LMSBAND/lms-rig/surface/enclosure/renders/corners.png

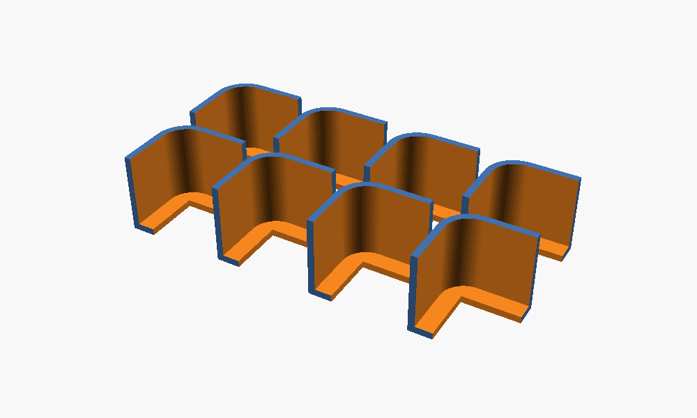
surface/enclosure/renders/corners.png
