LMSBAND/lms-rig/surface/enclosure/renders/faceplate_back.png

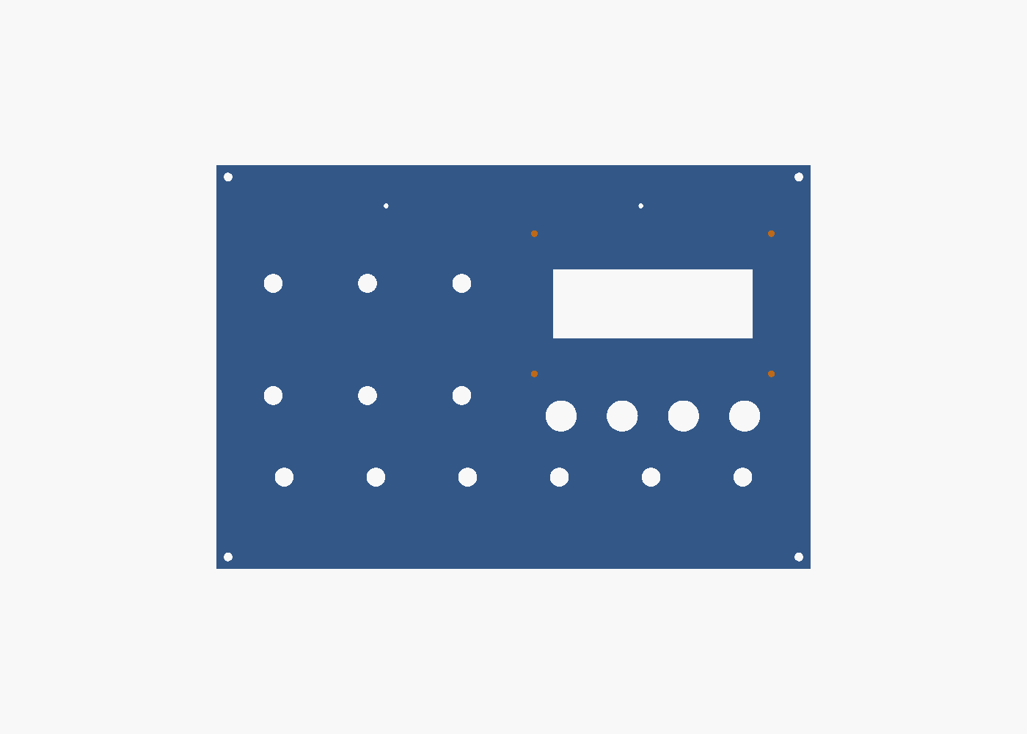
surface/enclosure/renders/faceplate_back.png
