LMSBAND/lms-rig/surface/enclosure/renders/handle.png

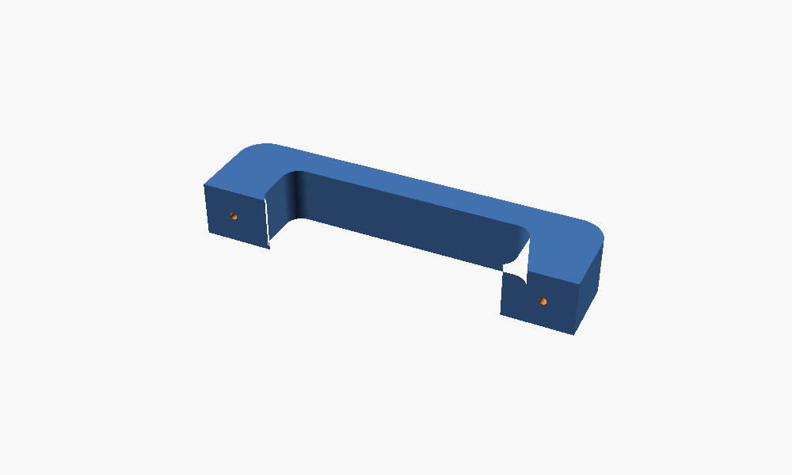
surface/enclosure/renders/handle.png
