LMSBAND/lms-rig/surface/enclosure/renders/head_front.png

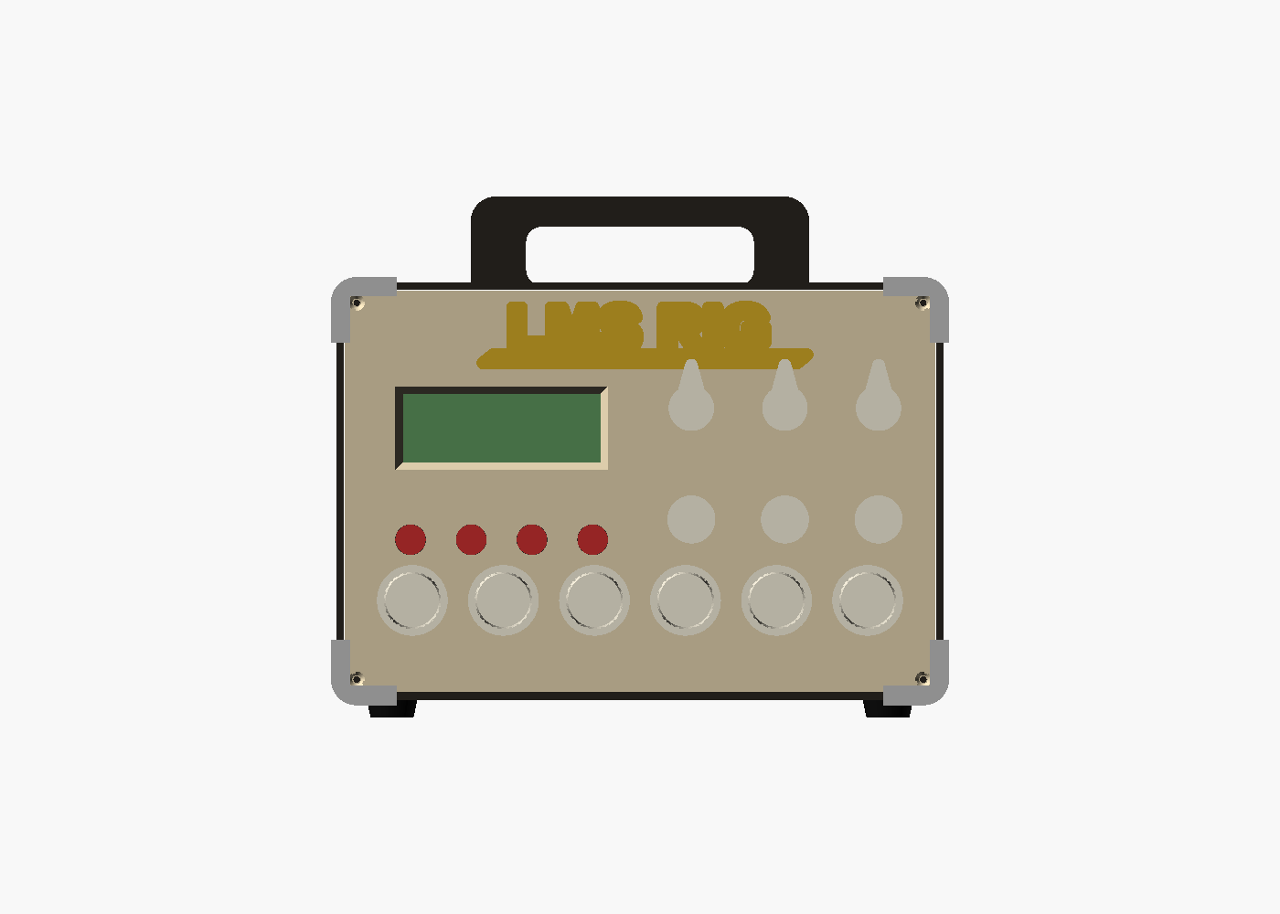
surface/enclosure/renders/head_front.png
