LMSBAND/lms-rig/surface/enclosure/renders/inserts.png

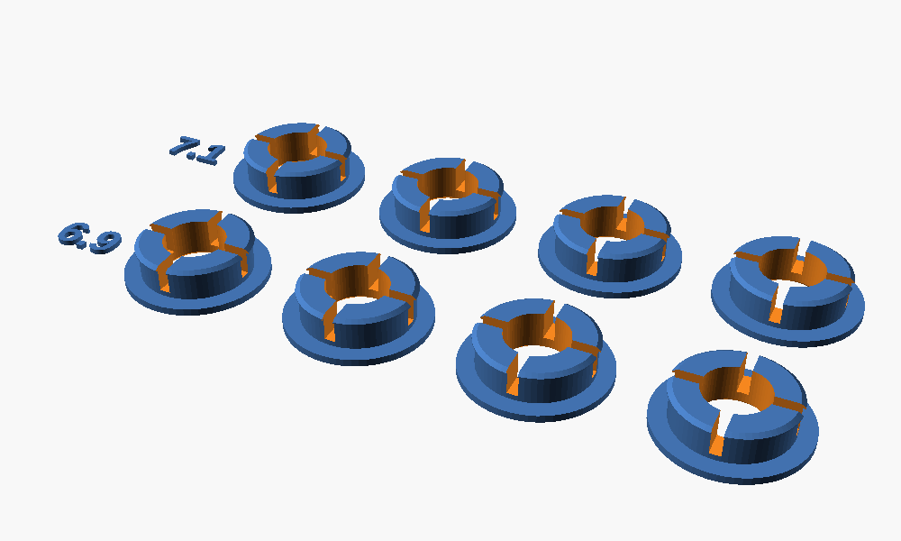
surface/enclosure/renders/inserts.png
