LMSBAND/lms-rig/surface/enclosure/stl/head_back.stl

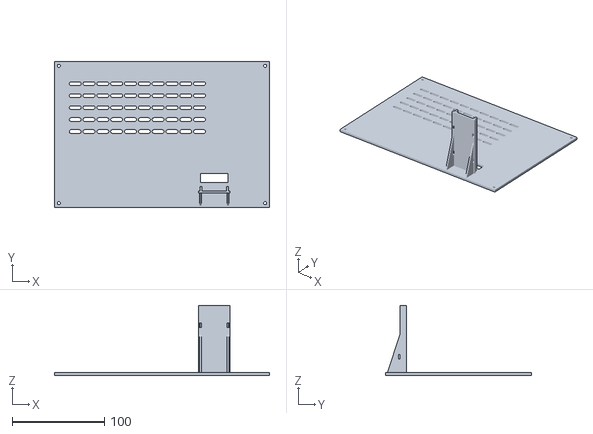
[picture p6: CAD file, 2026-10-26]
surface/enclosure/stl/head_back.stl
233.4 x 158.4 x 76.0
