LMSBAND/lms-rig/surface/enclosure/stl/head_badge.stl

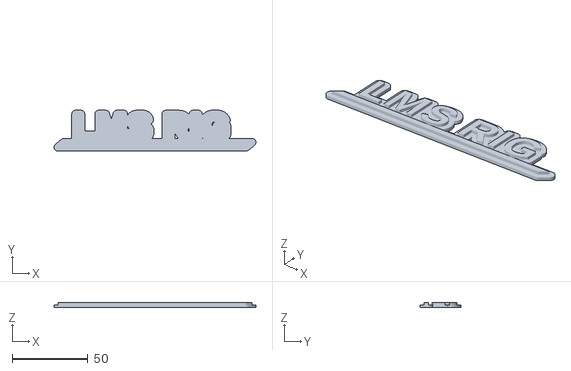
[picture p7: CAD file, 2026-10-26]
surface/enclosure/stl/head_badge.stl
133.2 x 27.2 x 3.40
