LMSBAND/lms-rig/surface/enclosure/stl/head_knobs.stl

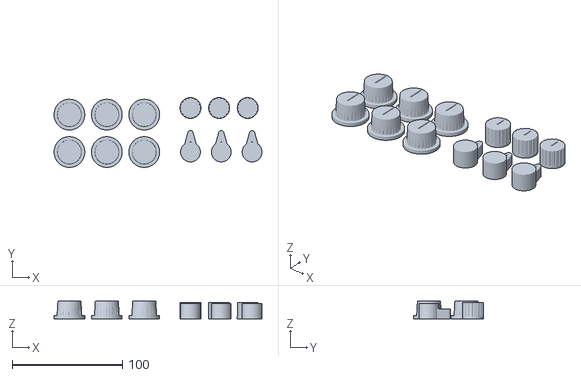
[picture p8: CAD file, 2026-10-26]
surface/enclosure/stl/head_knobs.stl
189.0 x 63.5 x 16.0
