LMSBAND/lms-rig/surface/enclosure/stl/head_inserts.stl

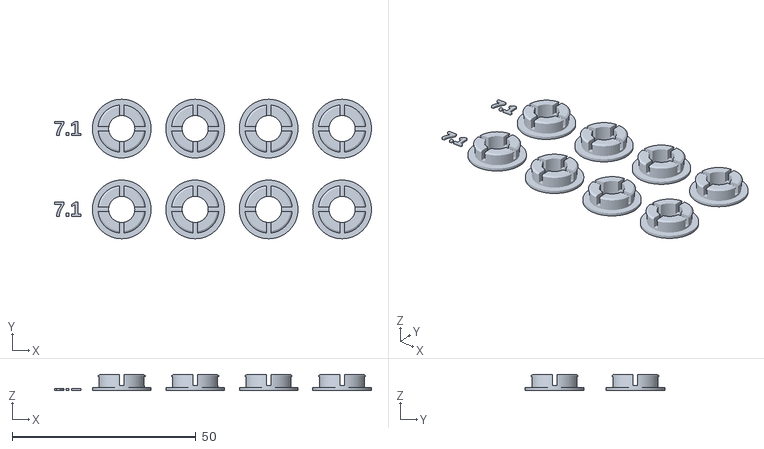
[picture p9: CAD file, 2026-10-26]
surface/enclosure/stl/head_inserts.stl
86.3 x 38.0 x 4.40
