LMSBAND/lms-rig/surface/enclosure/stl/head_sleeve.stl

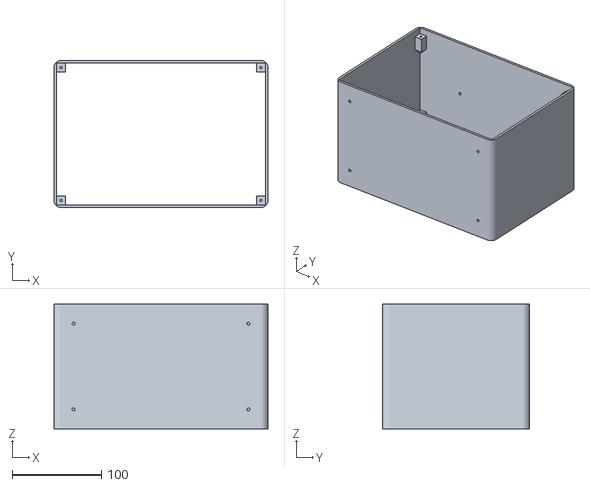
[picture p10: CAD file, 2026-10-26]
surface/enclosure/stl/head_sleeve.stl
240.0 x 165.0 x 140.0
