LMSBAND/lms-rig/surface/enclosure/stl/head_handle.stl

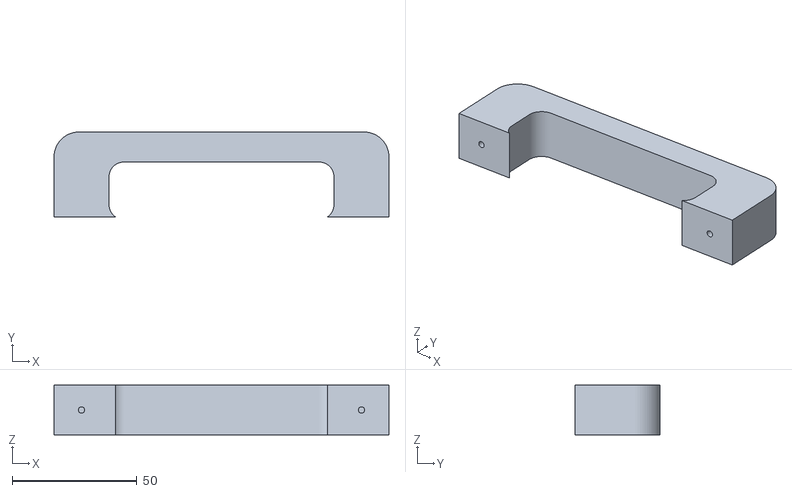
[picture p11: CAD file, 2026-10-26]
surface/enclosure/stl/head_handle.stl
134.0 x 34.0 x 20.0
