LMSBAND/lms-rig/surface/enclosure/stl/head_faceplate.3mf

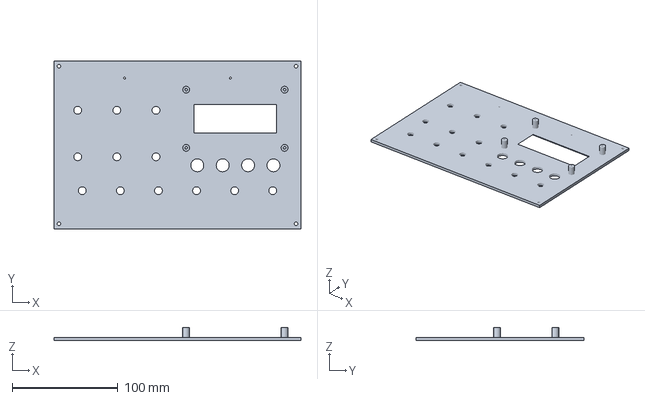
[picture p12: CAD file, 2026-10-26]
surface/enclosure/stl/head_faceplate.3mf
233.4 x 158.4 x 12.5 mm
