LMSBAND/lms-rig/surface/enclosure/stl/head_corners.stl

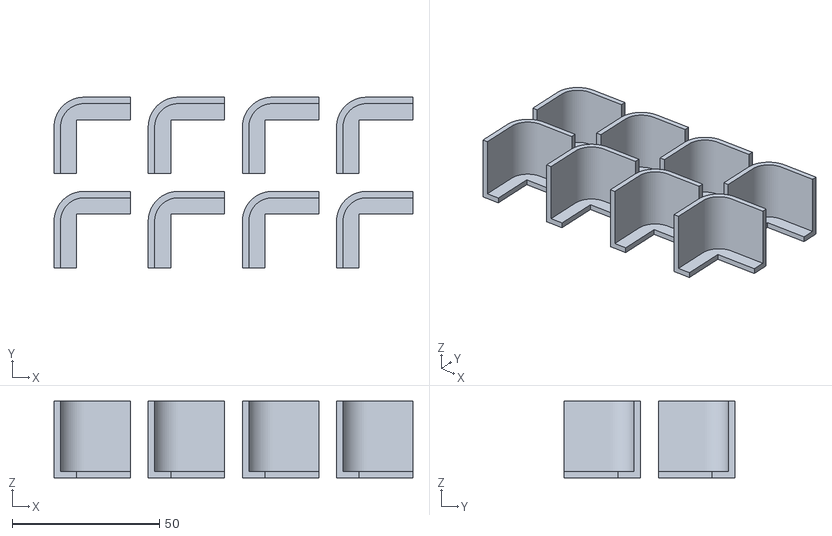
[picture p13: CAD file, 2026-10-26]
surface/enclosure/stl/head_corners.stl
122.0 x 58.0 x 26.0
