LMSBAND/lms-rig/surface/enclosure/stl/head_feet.stl

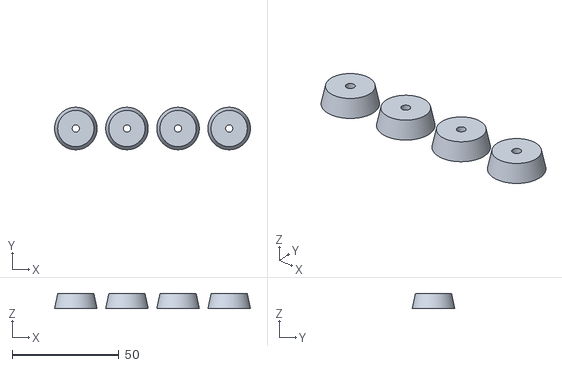
[picture p14: CAD file, 2026-10-26]
surface/enclosure/stl/head_feet.stl
92.0 x 20.0 x 7.00
