LMSBAND/lms-rig/(list of files, cad)

Other CAD files:
surface/enclosure/stl/head_faceplate.stl
