LMSBAND/lms-rig/surface/enclosure/renders/head_assembly.png

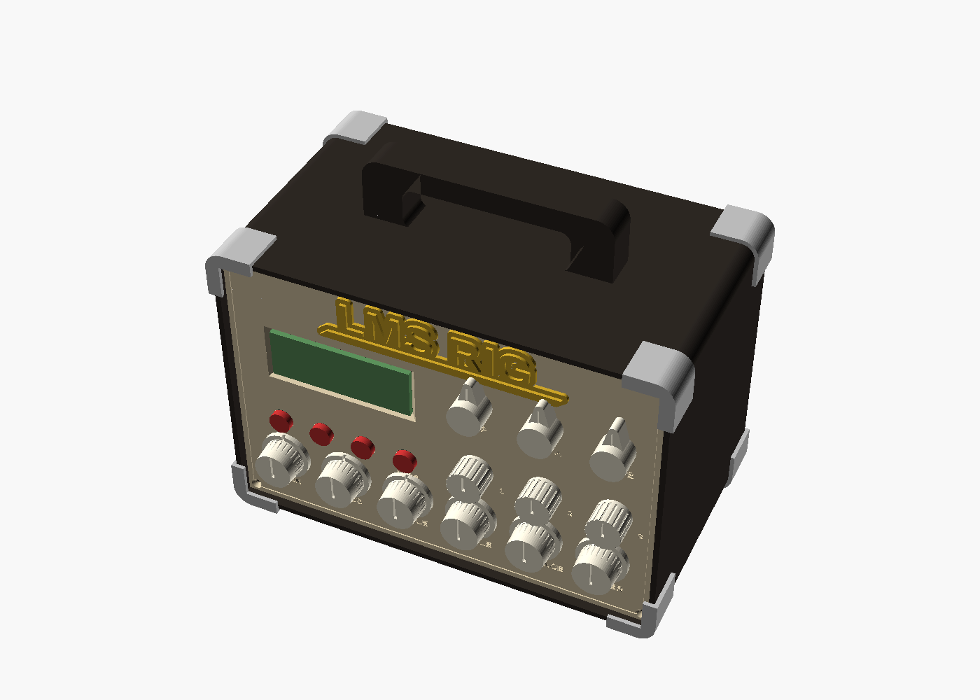
surface/enclosure/renders/head_assembly.png
