LMSBAND/lms-rig/surface/enclosure/renders/sleeve_print.png

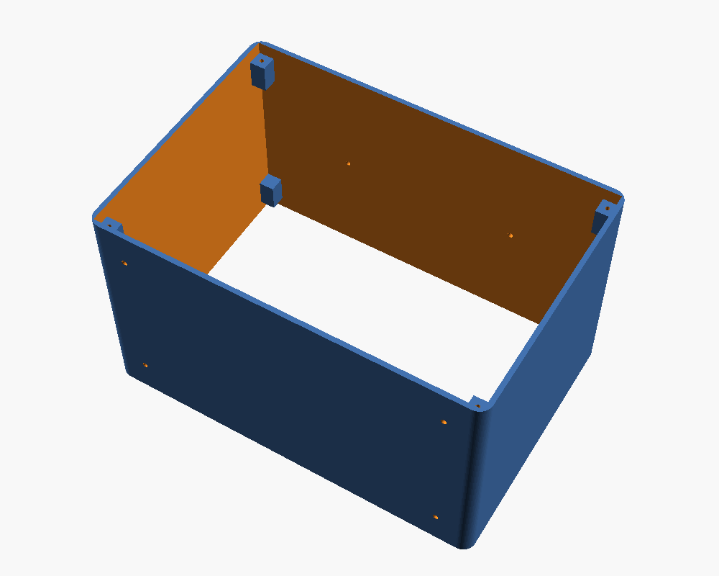
surface/enclosure/renders/sleeve_print.png
