LMSBAND/lms-rig/(commit log)

2026-10-17 LMS Rig: standalone pedalboard -> amp head -> cab host
    - ysfx-based JUCE host, three sections, amps switchable, cab state persists across heads
    - JSFX bundled into the binary, extracted to app data on launch
    - CI builds Linux, macOS universal, Windows
2026-10-17 Sync pedal circuit fixes; installer replaces running binary
    - jsfx/: RAT, TS, BD-2, ODB-3, spring, stepper, delay/flanger fixes from LMS
    - install.sh: unlink old binary before copy
2026-10-17 Native pedalboard and amp panels; hide inactive pedals
    - Pedals as stompbox cards with footswitches, comp strips, signal flow
    - Amp head as a faceplate of sections built from its sliders
    - Hide inactive toggle and Classic view toggle, saved with the rig
    - Keep the JSFX header and tuner strip above the native board
    - Amp picker follows the loaded head after a state load
2026-10-18 Fix output clipping, first-pick dropdowns; add impedance match light
    - Sync amps: true-peak limiter replaces the post-cab hard clamp
    - ysfx.patch: processSliderChanges no longer copies a stale slider back
    over a parameter edited mid-block (picks were being reverted)
    - Dropdowns open on click instead of press-and-hold
    - Cab sidebar shows cab load vs the amp's impedance tap
    [rig.cpp, rig_ui.h]
2026-10-19 Channel strip and master stages after the amp
    - RTW and Mega Increasinator bundled, switched into the chain from their panels
    - AMP / CHANNEL STRIP / MASTER tabs over the bottom area, native or classic view
    - RackPanel: sections by slider name, title-bar switches, GR meters, LUFS readouts
    - Stage states and the open tab saved with the rig
2026-10-19 Per-channel amp masters; sort any '... Master' into POWER
2026-10-20 Sync tuner fix: YIN sliced across blocks (no dropouts at 128 samples)
2026-10-24 Ideas: record, play back, open in REAPER, click
    - RECORD IDEA writes the take and a DI (24-bit WAV, device rate) to ~/Music/LMS Rig
    - a JSON sidecar per take: head, every slider of every stage, cab, click bpm, rig state
    - the idea list shows the takes played on the loaded head, newest first
    - play a take back after the chain, never re-recorded
    - REAPER: writes Idea <stamp>.RPP (take track + muted DI track with the LMS Rig VST3
    in the state it was played through, tempo = click) and launches reaper
    - metronome after the chain: bpm, level, higher ping on the one
    - FOLDER starts the file manager directly; xdg/kde-open hang on this desktop
2026-10-24 REAPER export: frame the VST3 chunk the way REAPER does; take on the one; rig-only track
    - body is [size][1][component state][0][0] and the header counts the framed body;
    REAPER now loads the rig in the state the take was played through (verified by
    reading the chunk back from a running REAPER)
    - starting a take restarts the click so beat one is the take's first sample and
    it sits on the project grid at 0
    - track 2 is the LMS Rig alone, no DI item, unmuted
2026-10-25 Head v0: KISS wiring and firmware
    - one ESP32-S3: pots on its ADC, ten switches on two resistor ladders, encoders on GPIO, the 20x4 on its I2C backpack, LED rings on four GPIO
    - USB-MIDI 'LMS Head' per surface/SPEC.md: 14-bit pots, button presses, selector indices, soft encoder accumulators, HELLO; LCD shows the rig's amp/cab names and the last touched control
    - compiles for esp32:esp32:esp32s3 with TinyUSB; untested on hardware
2026-10-25 Head v0: twelve pots, four buttons, the display; no encoders, no LEDs
2026-10-25 The HEAD control surface, v0
    - ControlSurface opens the box's MIDI ports by USB name (works in the standalone and in a DAW); CCs become slider moves on the message thread, labels / values / selections go back out only when they change
    - pots bound by slider name so they survive head swaps; MASTER is the selected channel's master; GAIN is remembered per channel per head (saved with the rig) and recalled on a channel change from the box or the app
    - AMP / CAB A / CAB B as selection indices with RANGE; the head's remaining sliders paged in threes on the soft pots and buttons, Channel first, button 4 = PAGE; HELLO gets the full dump
    - tested against a fake box on virtual MIDI: dump, gain, channe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
    [rig.cpp, rig.h, surface.cpp, surface.h]
2026-10-25 Head v0: the DFRobot I2C LCD wiring
2026-10-25 Head v0 on the classic ESP32: MIDI over USB serial
    - the board in hand is a 38-pin ESP32 DevKit (no native USB): firmware sends plain MIDI bytes on Serial at 115200; pots on ADC1 (36 39 34 35 32 33) and ADC2 (25 26 27 14 13 4), buttons 16-19, LCD on 21/22
    - the rig's surface pings every USB serial port and adopts the one that answers HELLO (LMS_HEAD_TTY overrides); same labels, values and gain memory as over MIDI
    - tested over a socat pty pair: dump, gain, channel switch with gain recall
2026-10-26 Head firmware: first run on hardware
    - per-pin ADC low-pass and a wider change threshold (the ESP32 ADC jitters ~1 % mid-travel)
    - LCD init retried, backlight polarity forced (DFRobot I2C LCD V1.2 fools hd44780's autodetect)
    - flash at 115200: the CP2102 drops the chip at 921600
    [head.ino]
2026-10-26 Head: page card and link timeout
    - PAGE (or a relabel) shows the three knobs' and buttons' names on the bottom lines for 3 s
    - rig sends BEAT once a second; 3 s of silence puts the box back on 'waiting for the rig'
2026-10-26 Head enclosure: OpenSCAD source, printed STLs, renders; the expanded-electronics notes
    - head.scad: sleeve, faceplate, badge, back, handle, feet, corners, knobs, button-hole inserts
    - stl/: the parts as printed (faceplate also as 3mf)
    - HEAD_PINS.md: the MCP3208/MCP23017/PCA9685/OLED version, kept as notes; v0 as built is HEAD_V0.md
    [head.scad, head_back.stl, head_badge.stl, head_corners.stl, head_faceplate.3mf, head_faceplate.stl, head_feet.stl, head_handle.stl]
2026-10-31 Rig: mono input, synced amp changes
    - Input 1 feeds both channels before the pedalboard (the amps average L+R)
    - Noise Gate, Gate Threshold, Hum Filter, Tight sit in the PREAMP section
    - JSFX synced from ~/LMS: presence shelves, cab rolloff, input expander, honest peak dB
    [rig.cpp, rig_ui.cpp]
2026-10-31 Sync: 12 Stepper period lock
2026-11-01 Build on Windows; CI patch matches the local ysfx
    - Serial HEAD box behind a small tty layer; Windows has no serial (MIDI box still works)
    - Fork/exec launcher Linux-only; Windows/macOS reveal folders and open .RPP via the OS
    - ysfx.patch adds hidden-view @gfx skip and ysfx_gmem_read
    [rig.cpp, surface.cpp]
2026-11-01 Ideas: ALL button shows every head's takes
    - Toggle next to the ideas list; entries show the head name when on
    - Saved with the rig state
2026-11-02 HEAD box goes wireless: BLE-MIDI as "LMS Head"
    - Firmware: BLE-MIDI alongside USB serial; replies on whichever transport the rig was last heard on
    - Bonds when the host pairs, never forces pairing (BlueZ cancels device-initiated pairing without an agent)
    - Bluetooth stays quiet until the rig speaks on it, so pot jitter can't starve pairing
    - Bluetooth rune top-right of the LCD whenever a host is connected
    - Hold PAGE at power-up to forget paired hosts
    - Rig (Linux): reconnects a paired "LMS Head" in the background, since BlueZ won't
    [head.ino, surface.cpp, surface.h]
